jgrage/stepper-board/motor.kicad_pcb

## KiCad design motor.kicad_pcb (2022-04-25)

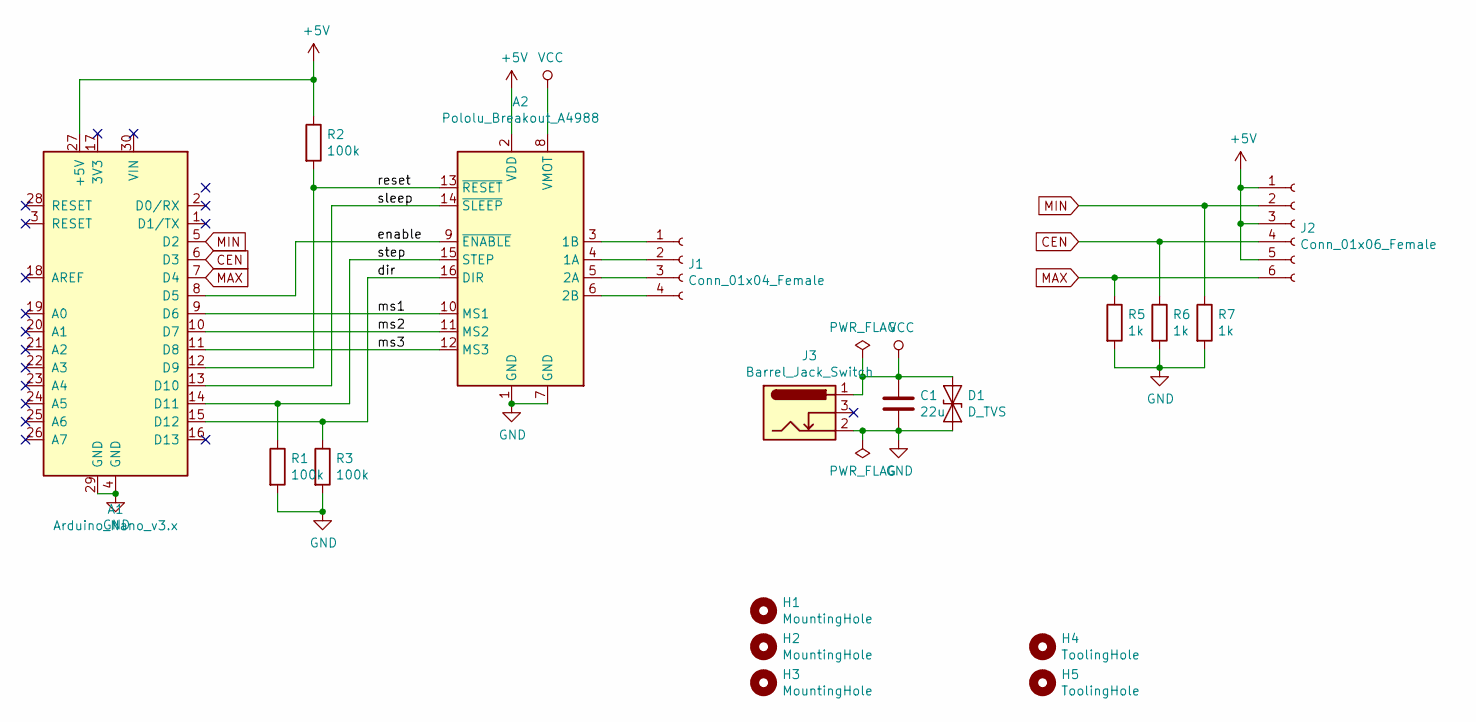
[picture p4: schematic motor.sch]

Parts:
A1: Arduino_Nano_v3.x; Arduino_Nano
A2: Pololu_Breakout_A4988; Pololu_Breakout-16_15.2x20.3mm
C1: 22u; C_1206_3216Metric; LCSC C13585
D1: D_TVS; D_SMB; LCSC C284012
H1, H2, H3: MountingHole; MountingHole_5mm
H4, H5: ToolingHole; Tooling_Hole_JLCPCB
J1: Conn_01x04_Female; PhoenixContact_MSTBA_2,5_4-G-5,08_1x04_P5.08mm_Horizontal
J2: Conn_01x06_Female; PhoenixContact_MC_1,5_6-G-3.5_1x06_P3.50mm_Horizontal
J3: Barrel_Jack_Switch; BarrelJack_Wuerth_6941xx301002
R1, R2, R3: 100k; R_0402_1005Metric; LCSC C25741
R5, R6, R7: 1k; R_0603_1608Metric; LCSC C25804

Connections:
+5V: A1.27 (+5V), A2.2 (VDD), J2.1, J2.3, J2.5, R2.1
/dir: A1.15 (D12), A2.16 (DIR), R3.1
/enable: A1.8 (D5), A2.9 (~ENABLE)
/ms1: A1.9 (D6), A2.10 (MS1)
/ms2: A1.10 (D7), A2.11 (MS2)
/ms3: A1.11 (D8), A2.12 (MS3)
/reset: A1.12 (D9), A2.13 (~RESET), R2.2
/sleep: A1.13 (D10), A2.14 (~SLEEP)
/step: A1.14 (D11), A2.15 (STEP), R1.1
CEN: A1.6 (D3), J2.4, R6.1
GND: A1.4 (GND), A1.29 (GND), A2.1 (GND), A2.7 (GND), C1.2, D1.2 (A2), J3.2, R1.2, R3.2, R5.2, R6.2, R7.2
MAX: A1.7 (D4), J2.6, R5.1
MIN: A1.5 (D2), J2.2, R7.1
unnamed: A2.3 (1B), J1.1
unnamed: A2.4 (1A), J1.2
unnamed: A2.5 (2A), J1.3
unnamed: A2.6 (2B), J1.4
VCC: A2.8 (VMOT), C1.1, D1.1 (A1), J3.1

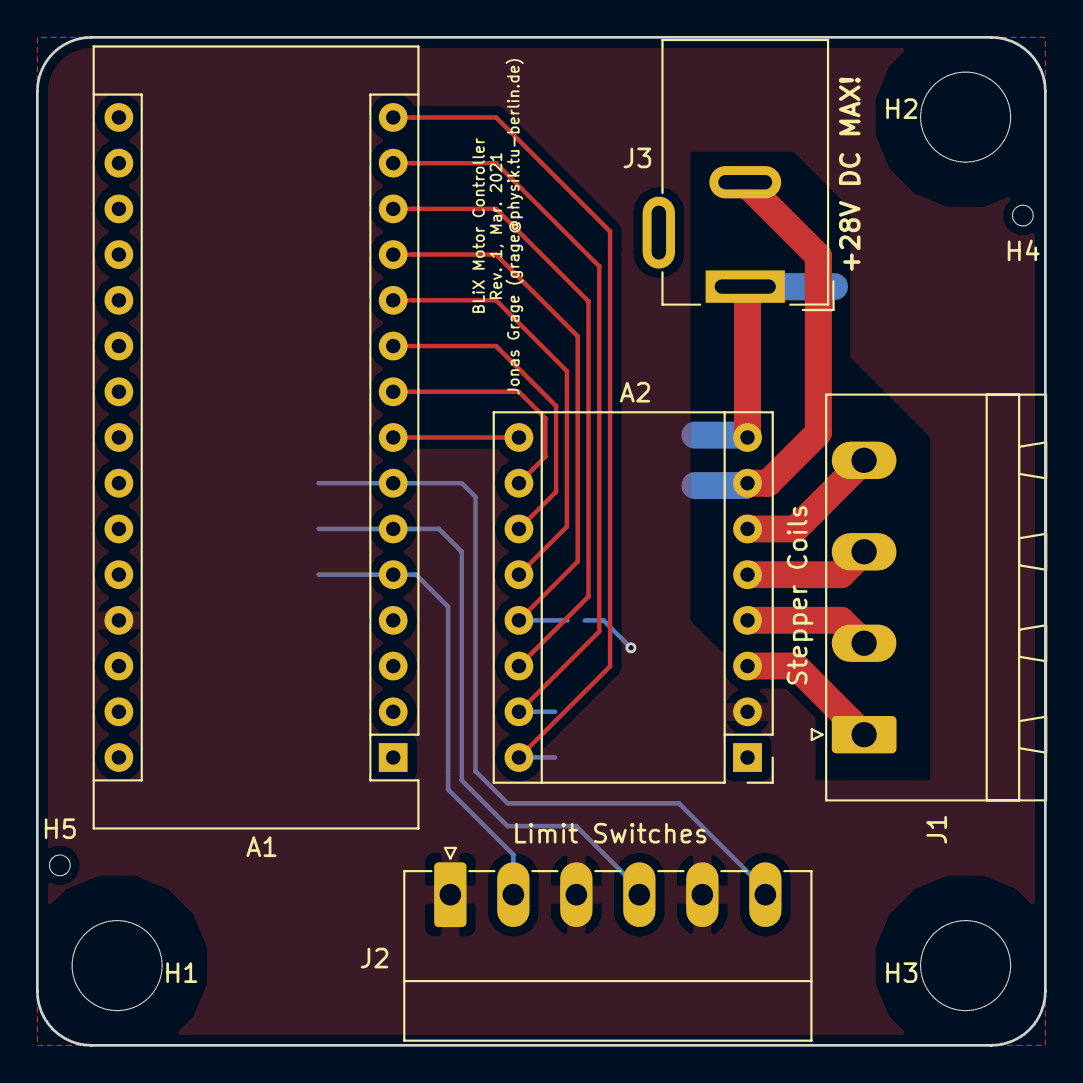
[picture p5: board motor.kicad_pcb from above]

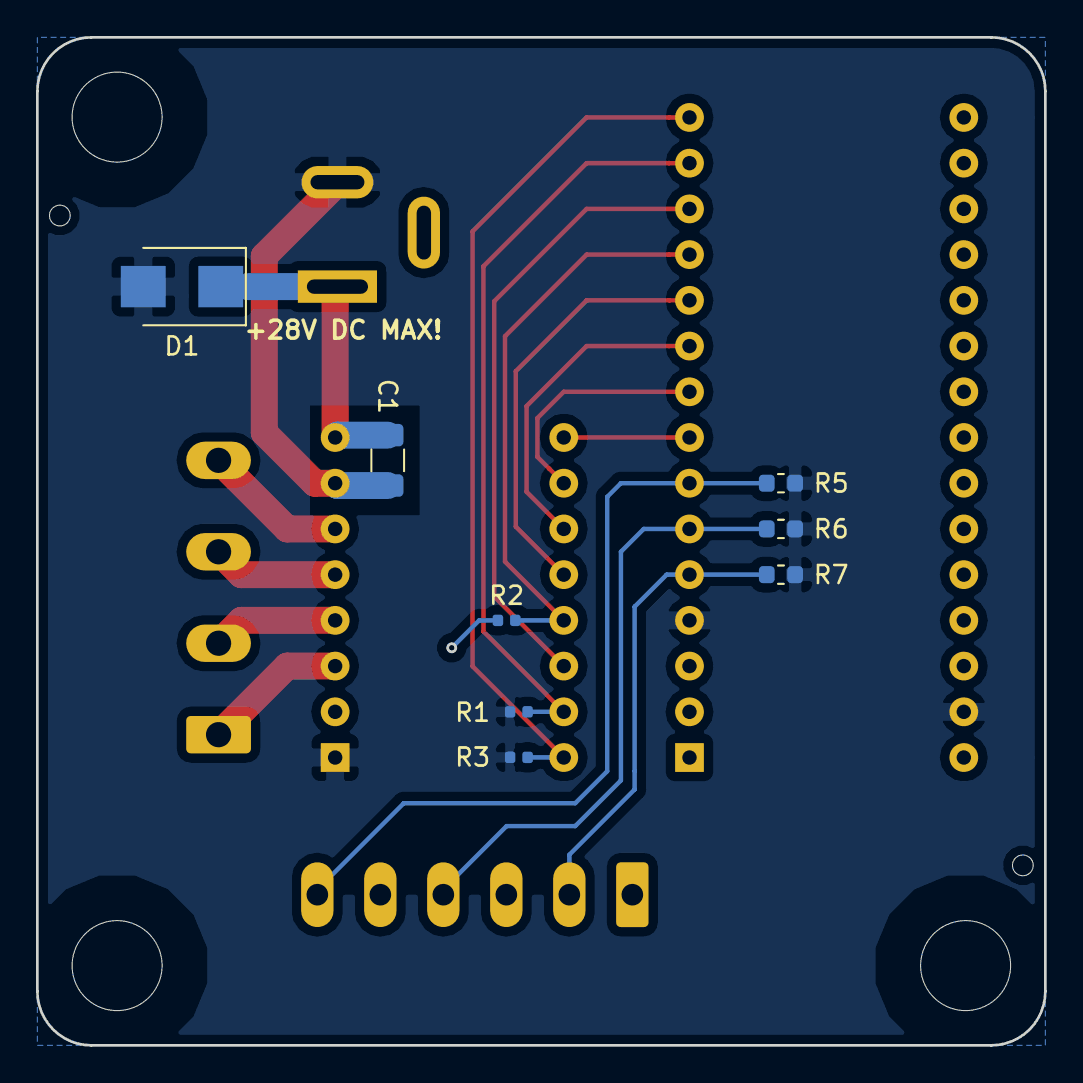
[picture p6: board motor.kicad_pcb from below]

Board: 2 copper layers, 56.0 x 56.0 mm, 18 parts (8 on the bottom side), 18 nets.
